dong-higenis/stm32h5-kit/hardware/stm32h5_kit.pdf

# 26.01.08 PHY (U16) 전원 수정

UART4 | (J21) 장치 선택 헤더 | 일체화 수정

## DCAB

6

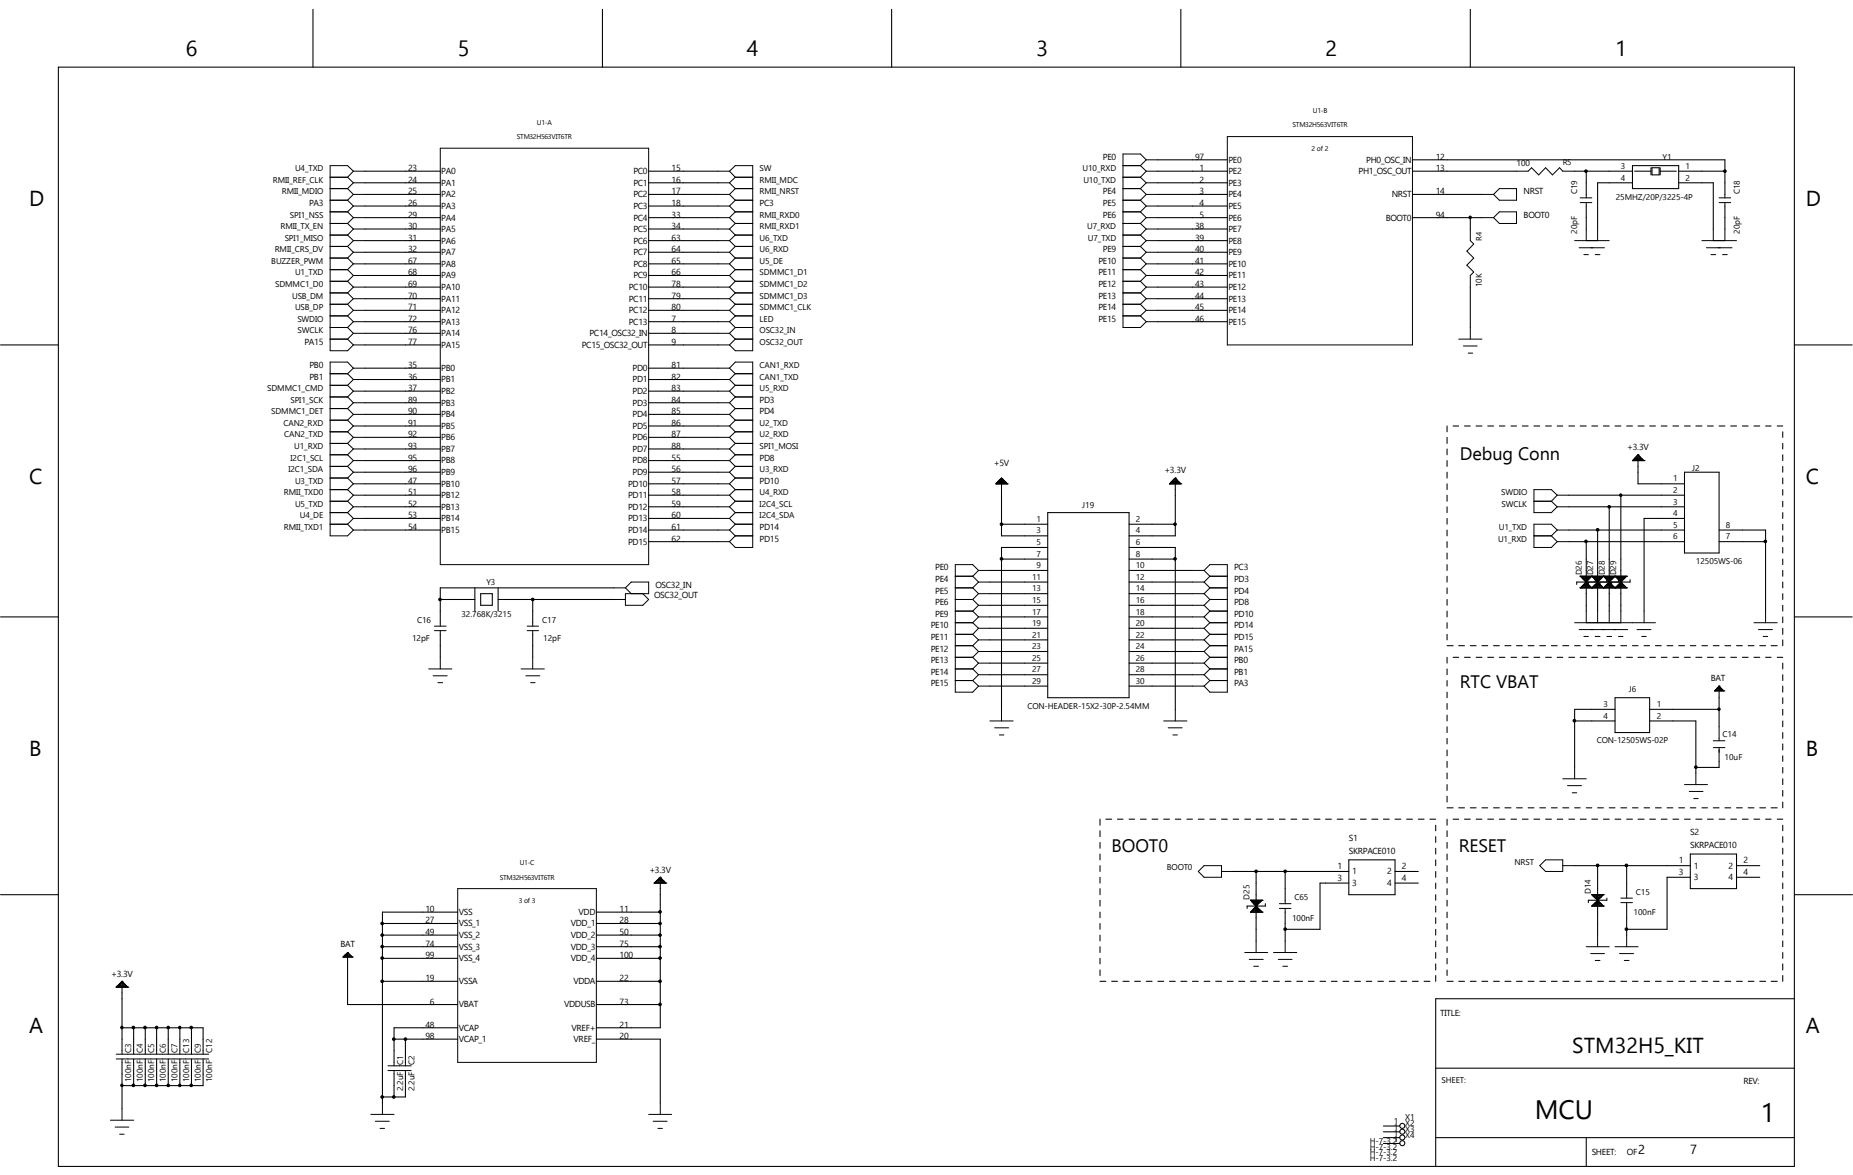
[picture p1: page 2]

12505WS-06 D²⁶ D²⁷ D²⁸ D²⁹ 1

27 VSS_1 | 28 VDD_1
49 VSS_2 | 50 VDD_2
74 VSS_3 | 75 VDD_3
99 VSS_4 | 100 VDD_4

D

6 | 5 | 4 | 3 | 2 | 1

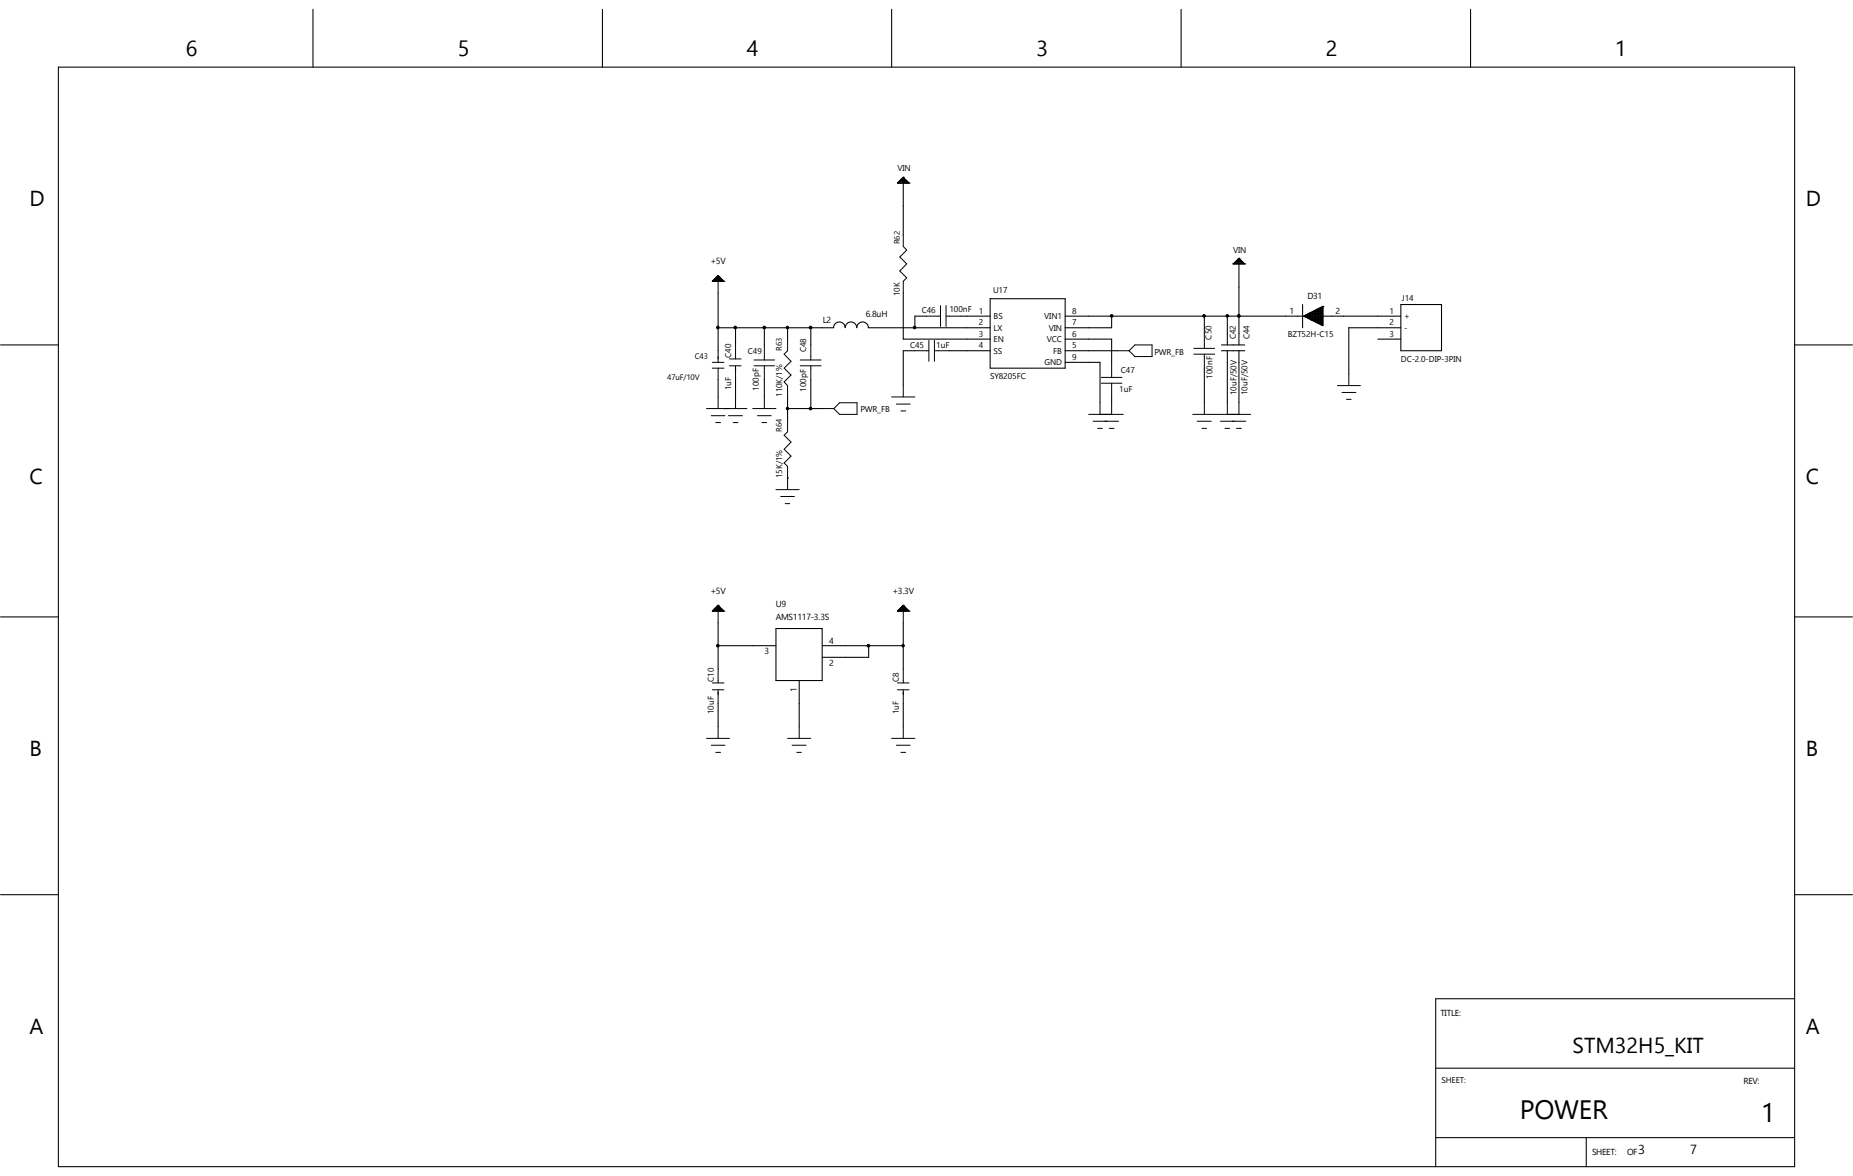
[picture p2: page 3]

D

6 | 5 | 4 | 3 | 2 | 1

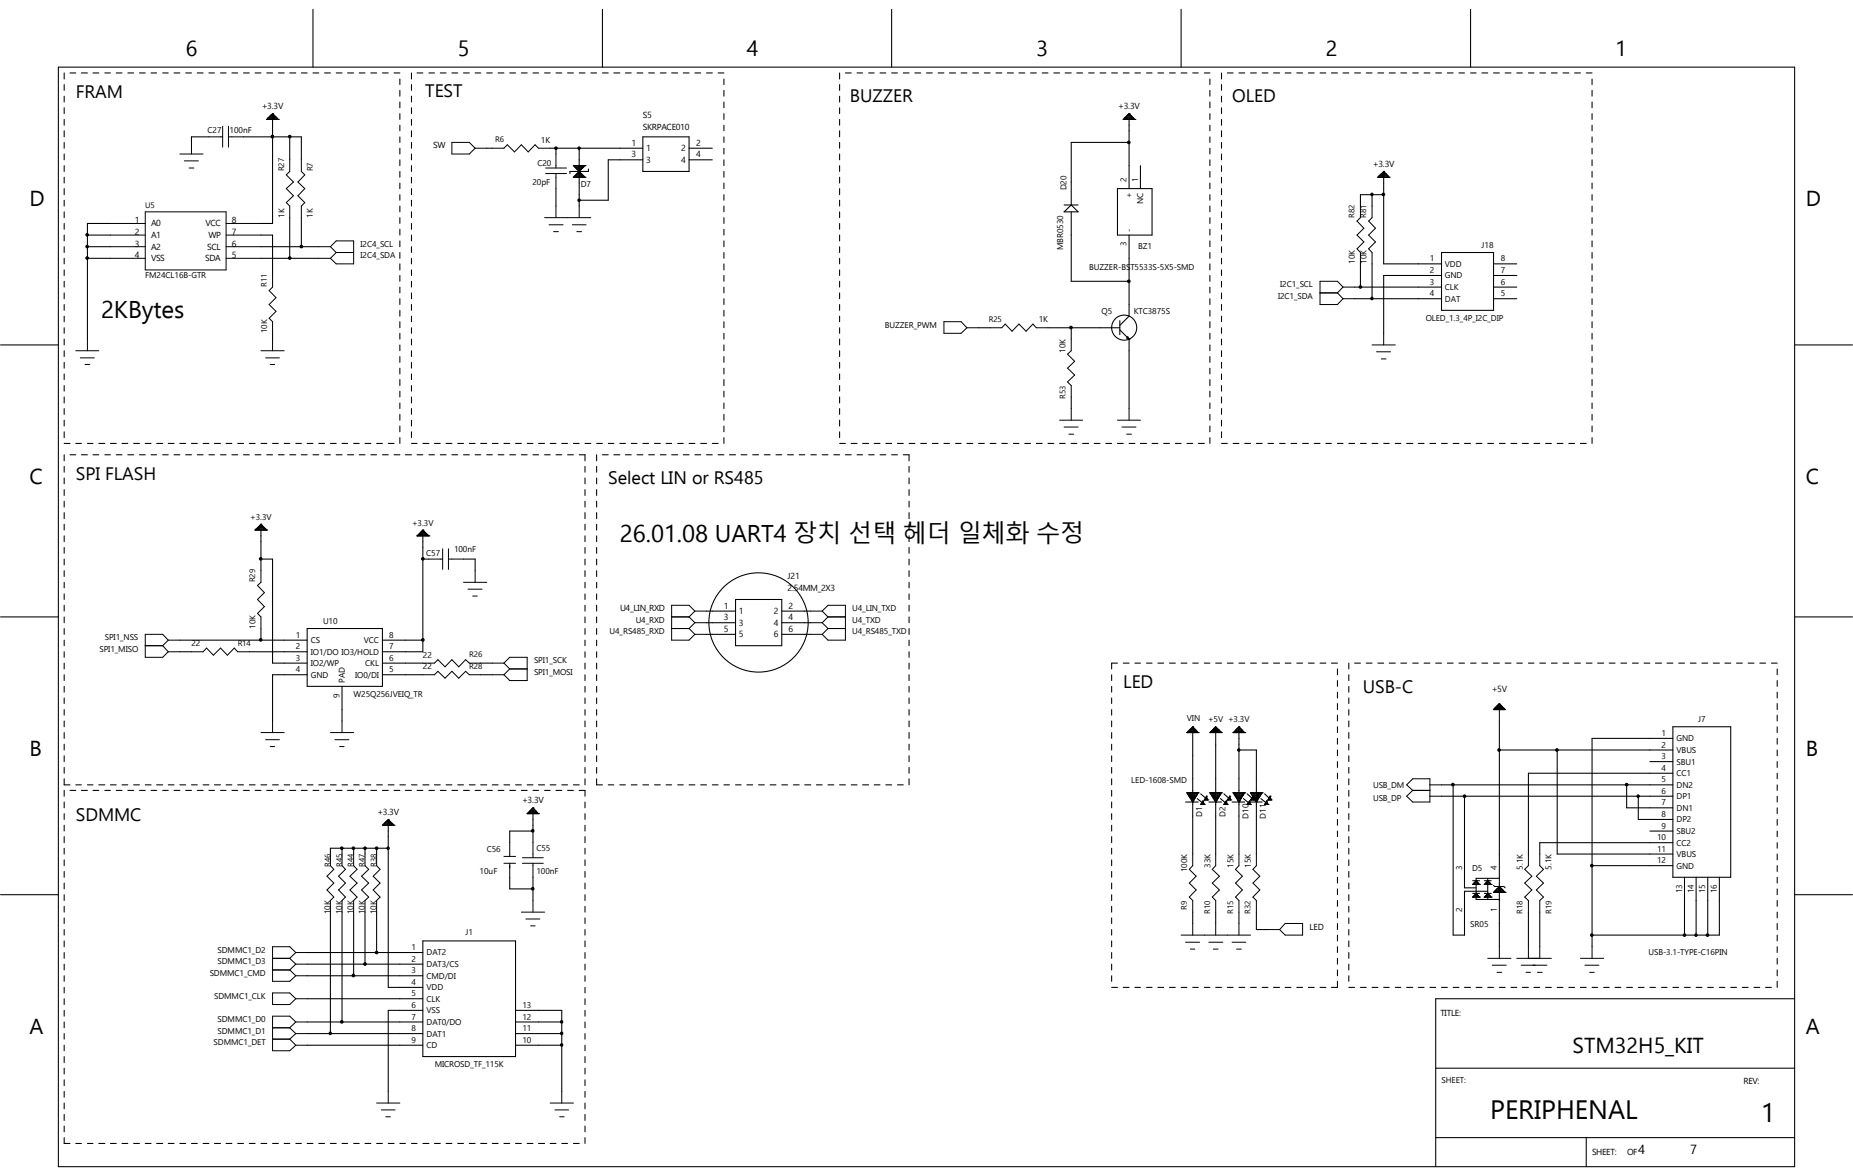
[picture p3: page 4]

Select LIN or RS485
26.01.08 UART4 장치 선택 헤더 일체화 수정

D

6 | 5 | 4 | 3 | 2 | 1

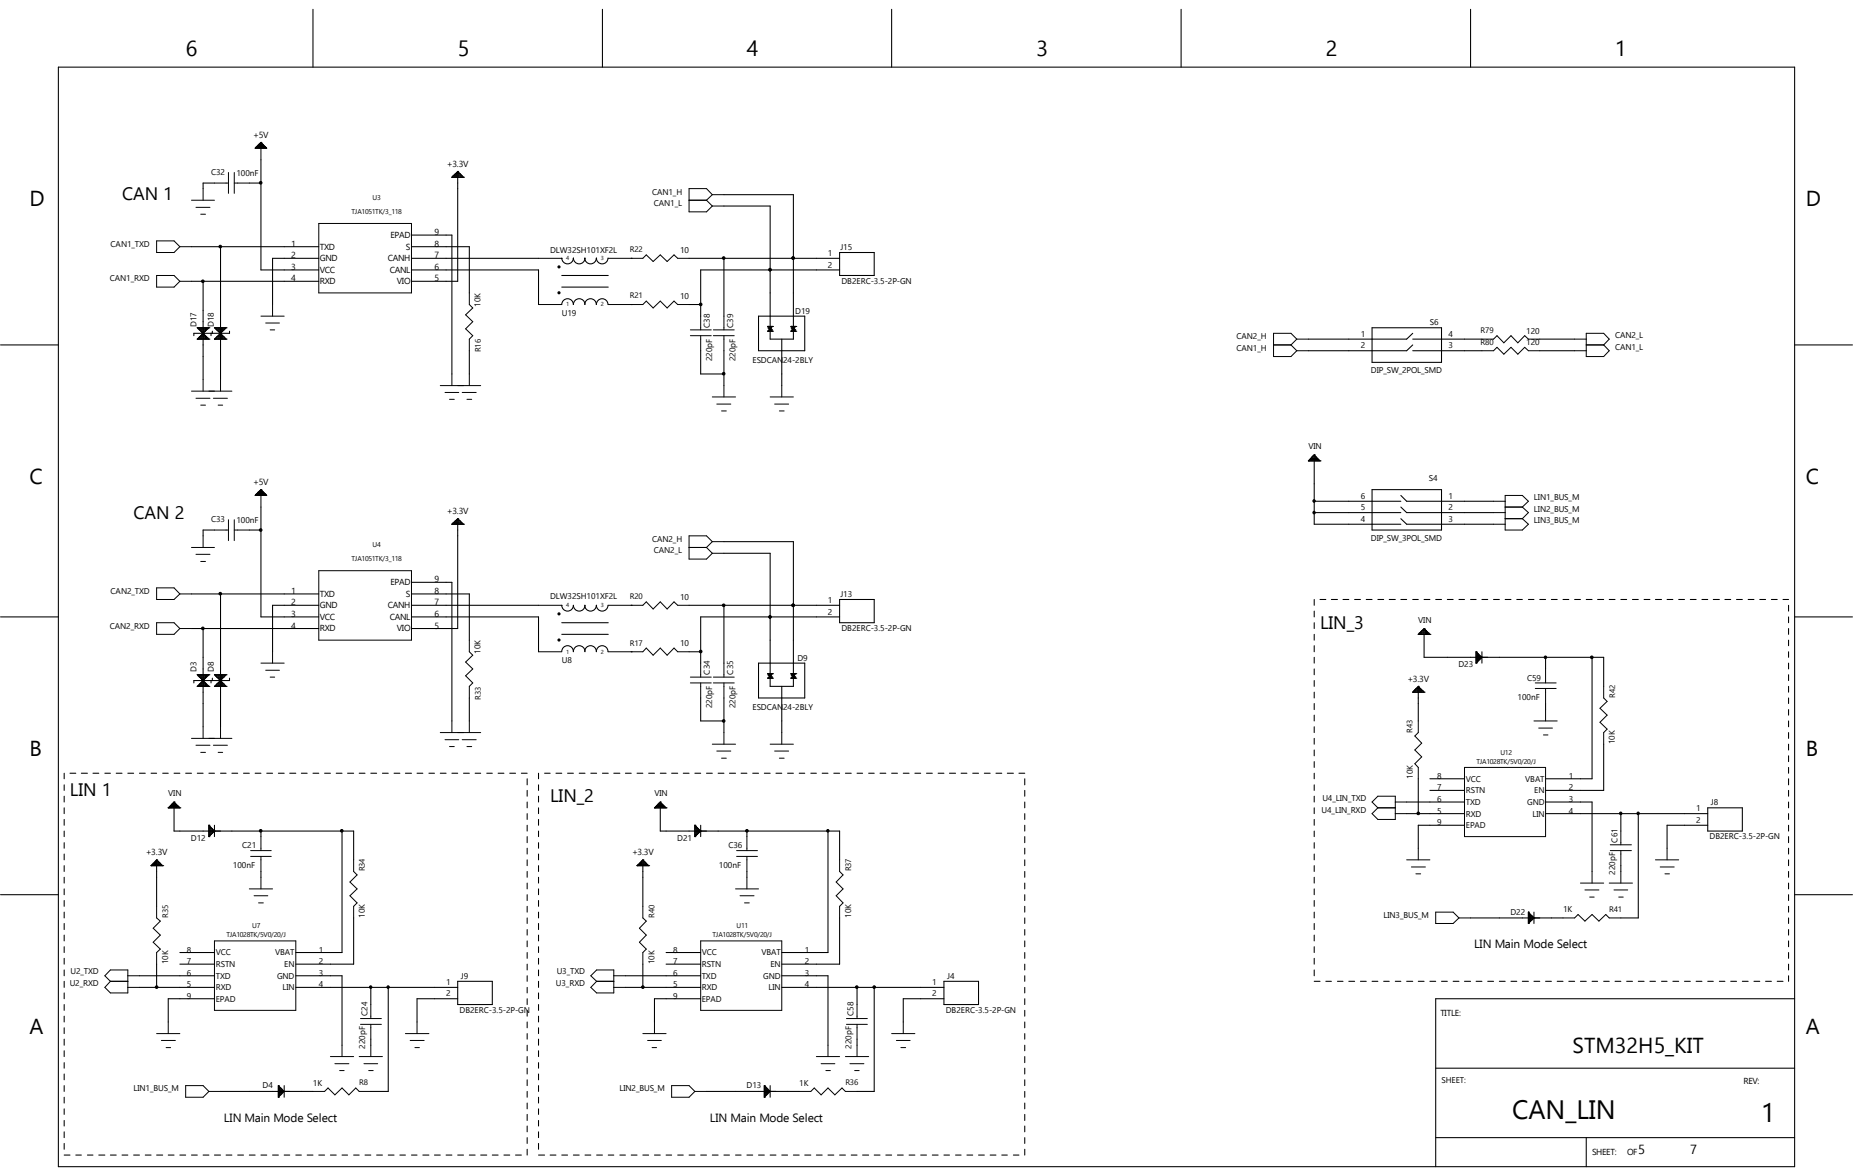
[picture p4: page 5]

7 CANH 6 CANL

LIN Main Mode Select

D

6 | 5 | 4 | 3 | 2 | 1

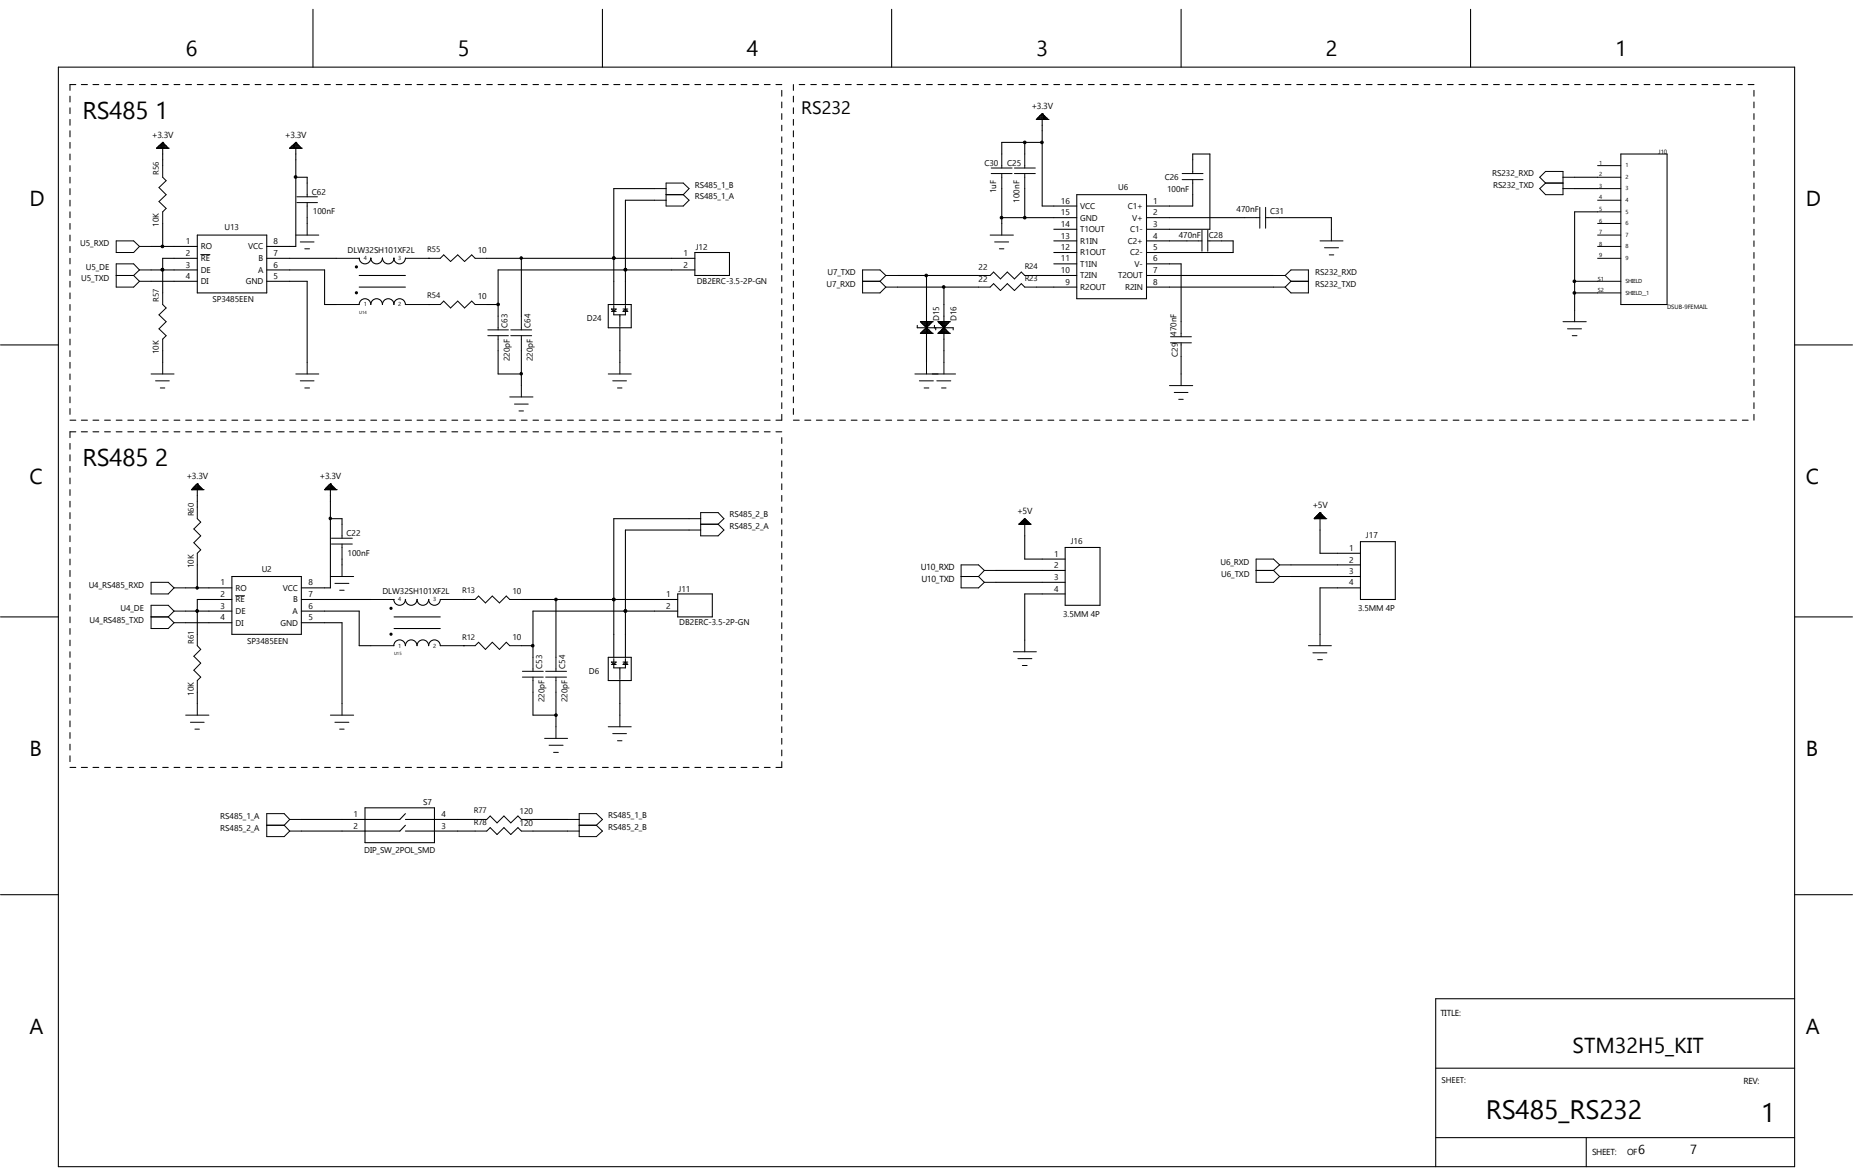
[picture p5: page 6]

5 GND

D

6 | 5 | 4 | 3 | 2 | 1

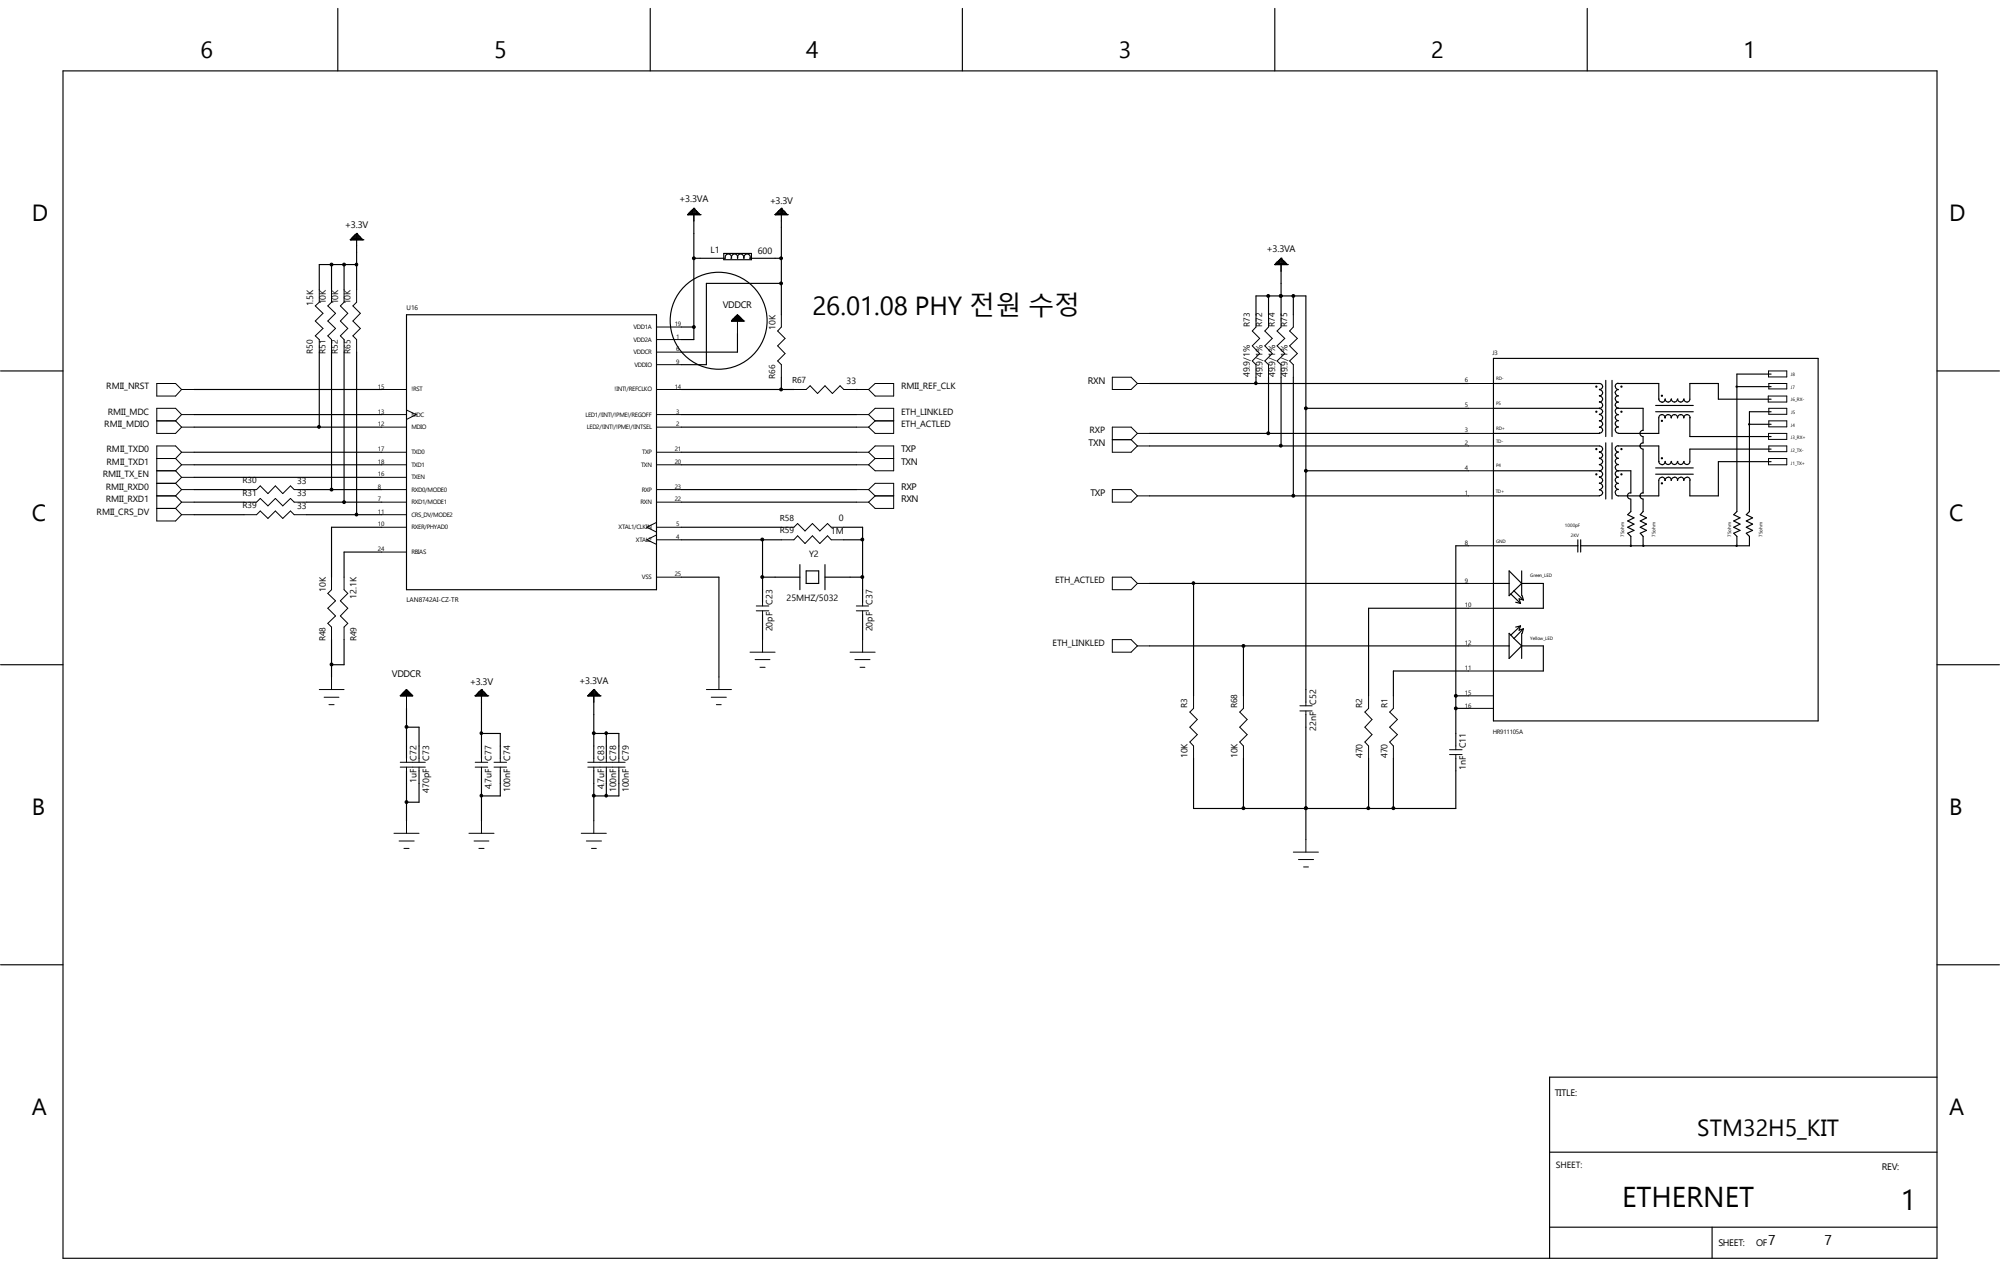
[picture p6: page 7]
