dong-higenis/stm32h5-kit/firmware/H5_SENSOR_READER/H5_SENSOR_READER.ioc

Mcu.UserName=STM32H563VITx
PA0.Signal=UART4_TX
PA9.Signal=USART1_TX
PB13.Signal=UART5_TX
PB14.GPIO_Label=U4_DE
PB14.Signal=GPIO_Output
PB7.Signal=USART1_RX
PB8.Signal=I2C1_SCL
PB9.Signal=I2C1_SDA
PC13.GPIO_Label=LED
PC13.Signal=GPIO_Output
PC14-OSC32_IN(OSC32_IN).Signal=RCC_OSC32_IN
PC15-OSC32_OUT(OSC32_OUT).Signal=RCC_OSC32_OUT
PC6.Signal=USART6_TX
PC7.Signal=USART6_RX
PC8.GPIO_Label=U5_DE
PC8.Signal=GPIO_Output
PD11.Signal=UART4_RX
PD2.Signal=UART5_RX
PE10.Signal=UART7_CTS
PE2.Signal=USART10_RX
PE3.Signal=USART10_TX
PE7.Signal=UART7_RX
PE8.Signal=UART7_TX
PE9.Signal=UART7_RTS
PH0-OSC_IN(PH0).Signal=RCC_OSC_IN
PH1-OSC_OUT(PH1).Signal=RCC_OSC_OUT
