dong-higenis/stm32h5-kit/firmware/H5_SENSOR_READER/Core/Inc/main.h

#define LED_Pin GPIO_PIN_13
#define LED_GPIO_Port GPIOC
#define U4_DE_Pin GPIO_PIN_14
#define U4_DE_GPIO_Port GPIOB
#define U5_DE_Pin GPIO_PIN_8
#define U5_DE_GPIO_Port GPIOC
