dong-higenis/stm32h5-kit/firmware/H5_CAN_LOGGER/src/hw/driver/i2c.c

#include "i2c.h"





#ifdef _USE_HW_I2C
#include "cli.h"

#ifdef _USE_HW_RTOS
#define lock(x)      xSemaphoreTake(mutex_lock[x], portMAX_DELAY);
#define unLock(x)    xSemaphoreGive(mutex_lock[x]);
static SemaphoreHandle_t mutex_lock[I2C_MAX_CH];
#else
#define lock(x)      
#define unLock(x)    
#endif

static uint32_t i2cGetTimming(uint32_t freq_khz);
static void delayUs(uint32_t us);
#ifdef _USE_HW_CLI
static void cliI2C(cli_args_t *args);
#endif



static uint32_t i2c_timeout[I2C_MAX_CH];
static uint32_t i2c_errcount[I2C_MAX_CH];
static uint32_t i2c_freq[I2C_MAX_CH];

static bool is_init = false;
static bool is_begin[I2C_MAX_CH];


static I2C_HandleTypeDef hi2c1;

typedef struct
{
  I2C_TypeDef       *p_i2c;
  I2C_HandleTypeDef *p_hi2c;

  GPIO_TypeDef *scl_port;
  int           scl_pin;

  GPIO_TypeDef *sda_port;
  int           sda_pin;

  const char   *p_name;
} i2c_tbl_t;

static i2c_tbl_t i2c_tbl[I2C_MAX_CH] = {
  {I2C1, &hi2c1, GPIOB, GPIO_PIN_8,  GPIOB, GPIO_PIN_9,  "I2C1 OLED"},  
};


bool i2cInit(void)
{
  uint32_t i;


  for (i=0; i<I2C_MAX_CH; i++)
  {
#ifdef _USE_HW_RTOS
    mutex_lock[i] = xSemaphoreCreateMutex();
#endif    
    i2c_timeout[i] = 10;
    i2c_errcount[i] = 0;
    is_begin[i] = false;
  }

#ifdef _USE_HW_CLI
  cliAdd("i2c", cliI2C);
#endif

  is_init = true;
  return true;
}

bool i2cIsInit(void)
{
  return is_init;
}

bool i2cBegin(uint8_t ch, uint32_t freq_khz)
{
  bool ret = false;

  I2C_HandleTypeDef *p_handle = i2c_tbl[ch].p_hi2c;

  if (ch >= I2C_MAX_CH)
  {
    return false;
  }


  switch(ch)
  {
    default:
      i2c_freq[ch] = freq_khz;

      p_handle->Instance             = i2c_tbl[ch].p_i2c;
      p_handle->Init.Timing          = i2cGetTimming(freq_khz);
      p_handle->Init.OwnAddress1     = 0x00;
      p_handle->Init.AddressingMode  = I2C_ADDRESSINGMODE_7BIT;
      p_handle->Init.DualAddressMode = I2C_DUALADDRESS_DISABLE;
      p_handle->Init.OwnAddress2     = 0x00;
      p_handle->Init.GeneralCallMode = I2C_GENERALCALL_DISABLE;
      p_handle->Init.NoStretchMode   = I2C_NOSTRETCH_DISABLE;

      i2cReset(ch);

      HAL_I2C_DeInit(p_handle);
      if(HAL_I2C_Init(p_handle) == HAL_OK)
      {
        ret = true;
      }

      /* Enable the Analog I2C Filter */
      HAL_I2CEx_ConfigAnalogFilter(p_handle,I2C_ANALOGFILTER_ENABLE);

      /* Configure Digital filter */
      HAL_I2CEx_ConfigDigitalFilter(p_handle, 0);

      is_begin[ch] = ret;
      break;
  }

  return ret;
}

uint32_t i2cGetTimming(uint32_t freq_khz)
{
  uint32_t ret;

  switch(freq_khz)
  {
    case 100:
      ret = 0x60808CD3;
      break;

    case 400:
      ret = 0x10C043E5;
      break;

    default:
      ret = 0x10C043E5;
      break;
  };

  return ret;
}

bool i2cIsBegin(uint8_t ch)
{
  return is_begin[ch];
}

void i2cReset(uint8_t ch)
{
  GPIO_InitTypeDef  GPIO_InitStruct;
  i2c_tbl_t *p_pin = &i2c_tbl[ch];

  lock(ch);
  GPIO_InitStruct.Pin       = p_pin->scl_pin;
  GPIO_InitStruct.Mode      = GPIO_MODE_OUTPUT_OD;
  GPIO_InitStruct.Pull      = GPIO_NOPULL;
  GPIO_InitStruct.Speed     = GPIO_SPEED_FREQ_HIGH;
  HAL_GPIO_Init(p_pin->scl_port, &GPIO_InitStruct);

  GPIO_InitStruct.Pin       = p_pin->sda_pin;
  GPIO_InitStruct.Mode      = GPIO_MODE_OUTPUT_OD;
  GPIO_InitStruct.Pull      = GPIO_NOPULL;
  HAL_GPIO_Init(p_pin->sda_port, &GPIO_InitStruct);


  HAL_GPIO_WritePin(p_pin->scl_port, p_pin->scl_pin, GPIO_PIN_SET);
  HAL_GPIO_WritePin(p_pin->sda_port, p_pin->sda_pin, GPIO_PIN_SET);
  delayUs(5);

  for (int i = 0; i < 9; i++)
  {

    HAL_GPIO_WritePin(p_pin->scl_port, p_pin->scl_pin, GPIO_PIN_RESET);
    delayUs(5);
    HAL_GPIO_WritePin(p_pin->scl_port, p_pin->scl_pin, GPIO_PIN_SET);
    delayUs(5);
  }

  HAL_GPIO_WritePin(p_pin->scl_port, p_pin->scl_pin, GPIO_PIN_RESET);
  delayUs(5);
  HAL_GPIO_WritePin(p_pin->sda_port, p_pin->sda_pin, GPIO_PIN_RESET);
  delayUs(5);

  HAL_GPIO_WritePin(p_pin->scl_port, p_pin->scl_pin, GPIO_PIN_SET);
  delayUs(5);
  HAL_GPIO_WritePin(p_pin->sda_port, p_pin->sda_pin, GPIO_PIN_SET);
  unLock(ch);
}

bool i2cIsDeviceReady(uint8_t ch, uint8_t dev_addr)
{
  bool ret = false;
  I2C_HandleTypeDef *p_handle = i2c_tbl[ch].p_hi2c;
  assert(is_begin[ch]);

  lock(ch);
  if (HAL_I2C_IsDeviceReady(p_handle, dev_addr << 1, 10, 10) == HAL_OK)
  {
    __enable_irq();
    ret = true;
  }
  unLock(ch);

  return ret;
}

bool i2cRecovery(uint8_t ch)
{
  bool ret;

  i2cReset(ch);

  ret = i2cBegin(ch, i2c_freq[ch]);

  return ret;
}

bool i2cReadByte (uint8_t ch, uint16_t dev_addr, uint16_t reg_addr, uint8_t *p_data, uint32_t timeout)
{
  return i2cReadBytes(ch, dev_addr, reg_addr, p_data, 1, timeout);
}

bool i2cReadBytes(uint8_t ch, uint16_t dev_addr, uint16_t reg_addr, uint8_t *p_data, uint32_t length, uint32_t timeout)
{
  bool ret;
  HAL_StatusTypeDef i2c_ret;
  I2C_HandleTypeDef *p_handle = i2c_tbl[ch].p_hi2c;

  if (ch >= I2C_MAX_CH)
  {
    return false;
  }

  lock(ch);
  i2c_ret = HAL_I2C_Mem_Read(p_handle, (uint16_t)(dev_addr << 1), reg_addr, I2C_MEMADD_SIZE_8BIT, p_data, length, timeout);
  unLock(ch);

  if( i2c_ret == HAL_OK )
  {
    ret = true;
  }
  else
  {
    ret = false;
  }

  return ret;
}

bool i2cReadA16Bytes(uint8_t ch, uint16_t dev_addr, uint16_t reg_addr, uint8_t *p_data, uint32_t length, uint32_t timeout)
{
  bool ret;
  HAL_StatusTypeDef i2c_ret;
  I2C_HandleTypeDef *p_handle = i2c_tbl[ch].p_hi2c;

  if (ch >= I2C_MAX_CH)
  {
    return false;
  }

  lock(ch);
  i2c_ret = HAL_I2C_Mem_Read(p_handle, (uint16_t)(dev_addr << 1), reg_addr, I2C_MEMADD_SIZE_16BIT, p_data, length, timeout);
  unLock(ch);

  if( i2c_ret == HAL_OK )
  {
    ret = true;
  }
  else
  {
    ret = false;
  }

  return ret;
}

bool i2cReadData(uint8_t ch, uint16_t dev_addr, uint8_t *p_data, uint32_t length, uint32_t timeout)
{
  bool ret;
  HAL_StatusTypeDef i2c_ret;
  I2C_HandleTypeDef *p_handle = i2c_tbl[ch].p_hi2c;

  if (ch >= I2C_MAX_CH)
  {
    return false;
  }

  lock(ch);
  i2c_ret = HAL_I2C_Master_Receive(p_handle, (uint16_t)(dev_addr << 1), p_data, length, timeout);
  unLock(ch);

  if( i2c_ret == HAL_OK )
  {
    ret = true;
  }
  else
  {
    ret = false;
  }

  return ret;
}

bool i2cWriteByte (uint8_t ch, uint16_t dev_addr, uint16_t reg_addr, uint8_t data, uint32_t timeout)
{
  return i2cWriteBytes(ch, dev_addr, reg_addr, &data, 1, timeout);
}

bool i2cWriteBytes(uint8_t ch, uint16_t dev_addr, uint16_t reg_addr, uint8_t *p_data, uint32_t length, uint32_t timeout)
{
  bool ret;
  HAL_StatusTypeDef i2c_ret;
  I2C_HandleTypeDef *p_handle = i2c_tbl[ch].p_hi2c;

  if (ch >= I2C_MAX_CH)
  {
    return false;
  }

  lock(ch);
  i2c_ret = HAL_I2C_Mem_Write(p_handle, (uint16_t)(dev_addr << 1), reg_addr, I2C_MEMADD_SIZE_8BIT, p_data, length, timeout);
  unLock(ch);

  if(i2c_ret == HAL_OK)
  {
    ret = true;
  }
  else
  {
    ret = false;
  }

  return ret;
}

bool i2cWriteA16Bytes(uint8_t ch, uint16_t dev_addr, uint16_t reg_addr, uint8_t *p_data, uint32_t length, uint32_t timeout)
{
  bool ret;
  HAL_StatusTypeDef i2c_ret;
  I2C_HandleTypeDef *p_handle = i2c_tbl[ch].p_hi2c;

  if (ch >= I2C_MAX_CH)
  {
    return false;
  }

  lock(ch);
  i2c_ret = HAL_I2C_Mem_Write(p_handle, (uint16_t)(dev_addr << 1), reg_addr, I2C_MEMADD_SIZE_16BIT, p_data, length, timeout);
  unLock(ch);

  if(i2c_ret == HAL_OK)
  {
    ret = true;
  }
  else
  {
    ret = false;
  }

  return ret;
}

bool i2cWriteData(uint8_t ch, uint16_t dev_addr, uint8_t *p_data, uint32_t length, uint32_t timeout)
{
  bool ret;
  HAL_StatusTypeDef i2c_ret;
  I2C_HandleTypeDef *p_handle = i2c_tbl[ch].p_hi2c;

  if (ch >= I2C_MAX_CH)
  {
    return false;
  }

  lock(ch);
  i2c_ret = HAL_I2C_Master_Transmit(p_handle, (uint16_t)(dev_addr << 1), p_data, length, timeout);
  unLock(ch);
  
  if(i2c_ret == HAL_OK)
  {
    ret = true;
  }
  else
  {
    ret = false;
  }

  return ret;
}

void i2cSetTimeout(uint8_t ch, uint32_t timeout)
{
  i2c_timeout[ch] = timeout;
}

uint32_t i2cGetTimeout(uint8_t ch)
{
  return i2c_timeout[ch];
}

void i2cClearErrCount(uint8_t ch)
{
  i2c_errcount[ch] = 0;
}

uint32_t i2cGetErrCount(uint8_t ch)
{
  return i2c_errcount[ch];
}

void delayUs(uint32_t us)
{
  volatile uint32_t i;

  for (i=0; i<us*1000; i++)
  {

  }
}





void HAL_I2C_ErrorCallback(I2C_HandleTypeDef *hi2c)
{
  UNUSED(hi2c);

}


void HAL_I2C_MspInit(I2C_HandleTypeDef* i2cHandle)
{
  GPIO_InitTypeDef GPIO_InitStruct = {0};
  RCC_PeriphCLKInitTypeDef PeriphClkInitStruct = {0};
  if(i2cHandle->Instance==I2C1)
  {

  /** Initializes the peripherals clock
  */
    PeriphClkInitStruct.PeriphClockSelection = RCC_PERIPHCLK_I2C1;
    PeriphClkInitStruct.I2c1ClockSelection = RCC_I2C1CLKSOURCE_PCLK1;
    if (HAL_RCCEx_PeriphCLKConfig(&PeriphClkInitStruct) != HAL_OK)
    {
      Error_Handler();
    }

    __HAL_RCC_GPIOB_CLK_ENABLE();
    /**I2C1 GPIO Configuration
    PB7     ------> I2C1_SDA
    PB8     ------> I2C1_SCL
    */
    GPIO_InitStruct.Pin = GPIO_PIN_9|GPIO_PIN_8;
    GPIO_InitStruct.Mode = GPIO_MODE_AF_OD;
    GPIO_InitStruct.Pull = GPIO_NOPULL;
    GPIO_InitStruct.Speed = GPIO_SPEED_FREQ_LOW;
    GPIO_InitStruct.Alternate = GPIO_AF4_I2C1;
    HAL_GPIO_Init(GPIOB, &GPIO_InitStruct);

    /* I2C1 clock enable */
    __HAL_RCC_I2C1_CLK_ENABLE();
  }
}

void HAL_I2C_MspDeInit(I2C_HandleTypeDef* i2cHandle)
{
  if(i2cHandle->Instance==I2C1)
  {
    /* Peripheral clock disable */
    __HAL_RCC_I2C1_CLK_DISABLE();

    /**I2C1 GPIO Configuration
    PB7     ------> I2C1_SDA
    PB8     ------> I2C1_SCL
    */
    HAL_GPIO_DeInit(GPIOB, GPIO_PIN_9);

    HAL_GPIO_DeInit(GPIOB, GPIO_PIN_8);
  }  
}


#ifdef _USE_HW_CLI
void cliI2C(cli_args_t *args)
{
  bool ret = false;
  bool i2c_ret;

  uint8_t print_ch;
  uint8_t ch;
  uint16_t dev_addr;
  uint16_t reg_addr;
  uint16_t length;
  uint32_t pre_time;

  if (args->argc == 1 && args->isStr(0, "info") == true)
  {
    for (int i=0; i<I2C_MAX_CH; i++)
    {
      cliPrintf("%02d. %-16s %03d Khz\n", 
        i+1,
        i2c_tbl[i].p_name,
        i2c_freq[i]
      );
    }
    ret = true;
  }

  if (args->argc == 2 && args->isStr(0, "scan") == true)
  {
    uint32_t dev_cnt = 0;
    print_ch = (uint16_t) args->getData(1);

    print_ch = constrain(print_ch, 1, I2C_MAX_CH);
    print_ch -= 1;

    for (int i=0x00; i<= 0x7F; i++)
    {
      if (i2cIsDeviceReady(print_ch, i) == true)
      {
        cliPrintf("I2C CH%d Addr 0x%02X : OK\n", print_ch+1, i);
        dev_cnt++;
      }
    }
    if (dev_cnt == 0)
    {
      cliPrintf("no found\n");
    }
    ret = true;  
  }

  if (args->argc == 2 && args->isStr(0, "begin") == true)
  {
    print_ch = (uint16_t) args->getData(1);

    print_ch = constrain(print_ch, 1, I2C_MAX_CH);
    print_ch -= 1;

    i2c_ret = i2cBegin(print_ch, 400);
    if (i2c_ret == true)
    {
      cliPrintf("I2C CH%d Begin OK\n", print_ch + 1);
    }
    else
    {
      cliPrintf("I2C CH%d Begin Fail\n", print_ch + 1);
    }
    ret = true;
  }

  if (args->argc == 5 && args->isStr(0, "read") == true)
  {
    print_ch = (uint16_t) args->getData(1);
    print_ch = constrain(print_ch, 1, I2C_MAX_CH);

    dev_addr = (uint16_t) args->getData(2);
    reg_addr = (uint16_t) args->getData(3);
    length   = (uint16_t) args->getData(4);
    ch       = print_ch - 1;

    for (int i=0; i<length; i++)
    {
      uint8_t i2c_data;
      i2c_ret = i2cReadByte(ch, dev_addr, reg_addr+i, &i2c_data, 100);

      if (i2c_ret == true)
      {
        cliPrintf("%d I2C - 0x%02X : 0x%02X\n", print_ch, reg_addr+i, i2c_data);
      }
      else
      {
        cliPrintf("%d I2C - Fail \n", print_ch);
        break;
      }
    }
    ret = true;
  }

  if (args->argc == 5 && args->isStr(0, "write") == true)
  {
    print_ch = (uint16_t) args->getData(1);
    print_ch = constrain(print_ch, 1, I2C_MAX_CH);

    dev_addr = (uint16_t) args->getData(2);
    reg_addr = (uint16_t) args->getData(3);
    length   = (uint16_t) args->getData(4);
    ch       = print_ch - 1;

    pre_time = millis();
    i2c_ret = i2cWriteByte(ch, dev_addr, reg_addr, (uint8_t)length, 100);

    if (i2c_ret == true)
    {
      cliPrintf("%d I2C - 0x%02X : 0x%02X, %d ms\n", print_ch, reg_addr, length, millis()-pre_time);
    }
    else
    {
      cliPrintf("%d I2C - Fail \n", print_ch);
    }
    ret = true;
  }


  if (ret == false)
  {
    cliPrintf("i2c info\n");
    cliPrintf("i2c begin ch[1~%d]\n", I2C_MAX_CH);
    cliPrintf("i2c scan  ch[1~%d]\n", I2C_MAX_CH);
    cliPrintf("i2c read  ch dev_addr reg_addr length\n");
    cliPrintf("i2c write ch dev_addr reg_addr data\n");
  }
}

#endif

#endif
