dong-higenis/stm32h5-kit/firmware/H5_CAN_LOGGER/src/hw/hw.c

#include "hw.h"


extern uint32_t _fw_flash_begin;
  extern UART_HandleTypeDef huart1;
volatile const firm_ver_t firm_ver __attribute__((section(".version"))) =
{
  .magic_number = VERSION_MAGIC_NUMBER,
  .version_str  = _DEF_FIRMWATRE_VERSION,
  .name_str     = _DEF_BOARD_NAME,
  .firm_addr    = (uint32_t)&_fw_flash_begin};

bool hwInit(void)
{
  cliInit();
  logInit();
  swtimerInit();
  microsInit();
  ledInit();
  uartInit();

  uartOpen(HW_UART_CH_DEBUG, 115200);

  logOpen(HW_LOG_CH, 115200);
  logPrintf("\r\n[ Firmware Begin... ]\r\n");
  logPrintf("Booting..Name \t\t: %s\r\n", _DEF_BOARD_NAME);
  logPrintf("Booting..Ver  \t\t: %s\r\n", _DEF_FIRMWATRE_VERSION);
  logPrintf("Booting..Clock\t\t: %d Mhz\r\n", (int)HAL_RCC_GetSysClockFreq() / 1000000);
  logPrintf("Booting..Date \t\t: %s\r\n", __DATE__);
  logPrintf("Booting..Time \t\t: %s\r\n", __TIME__);
  logPrintf("Booting..Addr \t\t: 0x%X\r\n", (uint32_t)&_fw_flash_begin);

  logPrintf("\n");

  rtcInit();
  resetInit();
  faultInit();
  assertInit();

  gpioInit();
  i2cInit();
  spiInit();
  buttonInit();
  buzzerInit();
  pwmInit();
  spiFlashInit();
  fsInit();
  nvsInit();
  lcdInit();
  canInit();
  sdInit();
  fatfsInit();
  etnetInit();
  threadInit();

  return true;
}
