dong-higenis/stm32h5-kit/firmware/H5_CAN_LOGGER/src/hw/driver/gpio.c

#include "gpio.h"


#ifdef _USE_HW_GPIO
#include "cli.h"


#define NAME_DEF(x) x, #x

typedef struct
{
  GPIO_TypeDef *port;
  uint32_t      pin;
  uint8_t       mode;
  GPIO_PinState on_state;
  GPIO_PinState off_state;
  bool          init_value;
  GpioPinName_t pin_name;
  const char   *p_name;
} gpio_tbl_t;

const gpio_tbl_t gpio_tbl[GPIO_MAX_CH] =
{
  {GPIOA, GPIO_PIN_4, _DEF_OUTPUT,        GPIO_PIN_SET, GPIO_PIN_RESET, _DEF_HIGH, NAME_DEF(SPI_FLASH_CS)},
  {GPIOB, GPIO_PIN_4, _DEF_INPUT_IT_BOTH, GPIO_PIN_SET, GPIO_PIN_RESET, _DEF_HIGH, NAME_DEF(SD_DETECT)   },
};


#ifdef _USE_HW_CLI
static void cliGpio(cli_args_t *args);
#endif


bool gpioInit(void)
{
  bool ret = true;

  __HAL_RCC_GPIOA_CLK_ENABLE();
  __HAL_RCC_GPIOB_CLK_ENABLE();
  __HAL_RCC_GPIOE_CLK_ENABLE();


  for (int i = 0; i < GPIO_MAX_CH; i++)
  {
    gpioPinMode(i, gpio_tbl[i].mode);
    gpioPinWrite(i, gpio_tbl[i].init_value);
  }

#ifdef _USE_HW_CLI
  cliAdd("gpio", cliGpio);
#endif

  return ret;
}

bool gpioPinMode(uint8_t ch, uint8_t mode)
{
  bool             ret             = true;
  GPIO_InitTypeDef GPIO_InitStruct = {0};


  if (ch >= GPIO_MAX_CH)
  {
    return false;
  }

  switch (mode)
  {
    case _DEF_INPUT:
      GPIO_InitStruct.Mode = GPIO_MODE_INPUT;
      GPIO_InitStruct.Pull = GPIO_NOPULL;
      break;

    case _DEF_INPUT_PULLUP:
      GPIO_InitStruct.Mode = GPIO_MODE_INPUT;
      GPIO_InitStruct.Pull = GPIO_PULLUP;
      break;

    case _DEF_INPUT_PULLDOWN:
      GPIO_InitStruct.Mode = GPIO_MODE_INPUT;
      GPIO_InitStruct.Pull = GPIO_PULLDOWN;
      break;

    case _DEF_OUTPUT:
      GPIO_InitStruct.Mode = GPIO_MODE_OUTPUT_PP;
      GPIO_InitStruct.Pull = GPIO_NOPULL;
      break;

    case _DEF_OUTPUT_PULLUP:
      GPIO_InitStruct.Mode = GPIO_MODE_OUTPUT_PP;
      GPIO_InitStruct.Pull = GPIO_PULLUP;
      break;

    case _DEF_OUTPUT_PULLDOWN:
      GPIO_InitStruct.Mode = GPIO_MODE_OUTPUT_PP;
      GPIO_InitStruct.Pull = GPIO_PULLDOWN;
      break;

    case _DEF_INPUT_IT_BOTH:
      GPIO_InitStruct.Mode = GPIO_MODE_IT_RISING_FALLING;
      GPIO_InitStruct.Pull = GPIO_PULLUP;
      break;
  }

  GPIO_InitStruct.Pin = gpio_tbl[ch].pin;
  HAL_GPIO_Init(gpio_tbl[ch].port, &GPIO_InitStruct);

  return ret;
}

void gpioPinWrite(uint8_t ch, bool value)
{
  if (ch >= GPIO_MAX_CH)
  {
    return;
  }

  if (value)
  {
    HAL_GPIO_WritePin(gpio_tbl[ch].port, gpio_tbl[ch].pin, gpio_tbl[ch].on_state);
  }
  else
  {
    HAL_GPIO_WritePin(gpio_tbl[ch].port, gpio_tbl[ch].pin, gpio_tbl[ch].off_state);
  }
}

bool gpioPinRead(uint8_t ch)
{
  bool ret = false;

  if (ch >= GPIO_MAX_CH)
  {
    return false;
  }

  if (HAL_GPIO_ReadPin(gpio_tbl[ch].port, gpio_tbl[ch].pin) == gpio_tbl[ch].on_state)
  {
    ret = true;
  }

  return ret;
}

void gpioPinToggle(uint8_t ch)
{
  if (ch >= GPIO_MAX_CH)
  {
    return;
  }

  HAL_GPIO_TogglePin(gpio_tbl[ch].port, gpio_tbl[ch].pin);
}


#ifdef _USE_HW_CLI
void cliGpio(cli_args_t *args)
{
  bool ret = false;


  if (args->argc == 1 && args->isStr(0, "info") == true)
  {
    for (int i = 0; i < GPIO_MAX_CH; i++)
    {
      cliPrintf("%d %-16s - %d\n", i, gpio_tbl[i].p_name, gpioPinRead(i));
    }
    ret = true;
  }

  if (args->argc == 1 && args->isStr(0, "show") == true)
  {
    while (cliKeepLoop())
    {
      for (int i = 0; i < GPIO_MAX_CH; i++)
      {
        cliPrintf("%02d %-16s - %d\n", i, gpio_tbl[i].p_name, gpioPinRead(i));
      }
      delay(100);
      cliMoveUp(GPIO_MAX_CH);
    }
    cliMoveDown(GPIO_MAX_CH);
    ret = true;
  }

  if (args->argc == 2 && args->isStr(0, "read") == true)
  {
    uint8_t ch;

    ch = (uint8_t)args->getData(1);

    while (cliKeepLoop())
    {
      cliPrintf("gpio read %d : %d\n", ch, gpioPinRead(ch));
      delay(100);
    }

    ret = true;
  }

  if (args->argc == 3 && args->isStr(0, "write") == true)
  {
    uint8_t ch;
    uint8_t data;

    ch   = (uint8_t)args->getData(1);
    data = (uint8_t)args->getData(2);

    gpioPinWrite(ch, data);

    cliPrintf("gpio write %d : %d\n", ch, data);
    ret = true;
  }

  if (ret != true)
  {
    cliPrintf("gpio info\n");
    cliPrintf("gpio show\n");
    cliPrintf("gpio read ch[0~%d]\n", GPIO_MAX_CH - 1);
    cliPrintf("gpio write ch[0~%d] 0:1\n", GPIO_MAX_CH - 1);
  }
}
#endif


#endif
