dong-higenis/stm32h5-kit/firmware/H5_CAN_LOGGER/src/hw/driver/buzzer.c

#include "buzzer.h"


#ifdef _USE_HW_BUZZER
#include "cli.h"
#include "swtimer.h"


static bool is_init = false;
static bool is_on = false;
static uint16_t on_time_cnt = 0;
static TIM_HandleTypeDef htim2;


#ifdef _USE_HW_CLI
static void cliBuzzer(cli_args_t *args);
#endif
static bool buzzerInitTimer(void);


void buzzerISR(void *arg)
{
  if (is_on && on_time_cnt > 0)
  {
    on_time_cnt--;

    if (on_time_cnt == 0)
    {
      buzzerOff();
    }
  }
}




bool buzzerInit(void)
{
  bool ret = true;


  ret = buzzerInitTimer();
  assert(ret);

  swtimer_handle_t timer_ch;
  timer_ch = swtimerGetHandle();
  swtimerSet(timer_ch, 1, LOOP_TIME, buzzerISR, NULL);
  swtimerStart(timer_ch);

  
#ifdef _USE_HW_CLI
  cliAdd("buzzer", cliBuzzer);
#endif  

  logPrintf("[%s] buzzerInit()\n", ret ? "OK":"NG");

  is_init = ret;
  return ret;
}

bool buzzerInitTimer(void)
{
  bool ret = true;
  TIM_ClockConfigTypeDef sClockSourceConfig = {0};
  TIM_MasterConfigTypeDef sMasterConfig = {0};
  TIM_OC_InitTypeDef sConfigOC = {0};
  // TIM_BreakDeadTimeConfigTypeDef sBreakDeadTimeConfig = {0};
  GPIO_InitTypeDef GPIO_InitStruct = {0};


  __HAL_RCC_TIM2_CLK_ENABLE();

  htim2.Instance = TIM2;
  htim2.Init.Prescaler = 249;
  htim2.Init.CounterMode = TIM_COUNTERMODE_UP;
  htim2.Init.Period = 1000;
  htim2.Init.ClockDivision = TIM_CLOCKDIVISION_DIV1;
  htim2.Init.RepetitionCounter = 0;
  htim2.Init.AutoReloadPreload = TIM_AUTORELOAD_PRELOAD_ENABLE;
  if (HAL_TIM_Base_Init(&htim2) != HAL_OK)
  {
    ret = false;
  }
  sClockSourceConfig.ClockSource = TIM_CLOCKSOURCE_INTERNAL;
  if (HAL_TIM_ConfigClockSource(&htim2, &sClockSourceConfig) != HAL_OK)
  {
    ret = false;
  }
  if (HAL_TIM_OC_Init(&htim2) != HAL_OK)
  {
    ret = false;
  }
  sMasterConfig.MasterOutputTrigger = TIM_TRGO_RESET;
  sMasterConfig.MasterSlaveMode = TIM_MASTERSLAVEMODE_DISABLE;
  if (HAL_TIMEx_MasterConfigSynchronization(&htim2, &sMasterConfig) != HAL_OK)
  {
    ret = false;
  }
  sConfigOC.OCMode = TIM_OCMODE_TOGGLE;
  sConfigOC.Pulse = 0;
  sConfigOC.OCPolarity = TIM_OCPOLARITY_HIGH;
  sConfigOC.OCNPolarity = TIM_OCNPOLARITY_HIGH;
  sConfigOC.OCFastMode = TIM_OCFAST_DISABLE;
  sConfigOC.OCIdleState = TIM_OCIDLESTATE_RESET;
  sConfigOC.OCNIdleState = TIM_OCNIDLESTATE_RESET;
  if (HAL_TIM_OC_ConfigChannel(&htim2, &sConfigOC, TIM_CHANNEL_1) != HAL_OK)
  {
    ret = false;
  }
  __HAL_TIM_ENABLE_OCxPRELOAD(&htim2, TIM_CHANNEL_1);


  __HAL_RCC_GPIOA_CLK_ENABLE();
  /**TIM2 GPIO Configuration
  PA15(JTDI)     ------> TIM2_CH1
  */
  GPIO_InitStruct.Pin = GPIO_PIN_15;
  GPIO_InitStruct.Mode = GPIO_MODE_AF_PP;
  GPIO_InitStruct.Pull = GPIO_NOPULL;
  GPIO_InitStruct.Speed = GPIO_SPEED_FREQ_LOW;
  GPIO_InitStruct.Alternate = GPIO_AF1_TIM2;
  HAL_GPIO_Init(GPIOA, &GPIO_InitStruct);

  return ret;
}

void buzzerOn(uint16_t freq_hz, uint16_t time_ms)
{
  uint32_t freq_cmp;

  freq_cmp = (1000000/freq_hz) - 1;

  if (freq_hz >= 20 && freq_hz <= 500000)
  {
    htim2.Instance->ARR = freq_cmp/2;

    HAL_TIM_OC_Start(&htim2, TIM_CHANNEL_1);
  }
  is_on = true;
  on_time_cnt = time_ms;
}

void buzzerBeep(uint16_t time_ms)
{
  buzzerOn(1000, time_ms);
}

void buzzerOff(void)
{
  HAL_TIM_OC_Stop(&htim2, TIM_CHANNEL_1);

  is_on = false;
}

#ifdef _USE_HW_CLI
void cliBuzzer(cli_args_t *args)
{
  bool ret = false;


  if (args->argc == 3 && args->isStr(0, "on"))
  {
    uint16_t freq_hz;
    uint16_t time_ms;

    freq_hz = args->getData(1);
    time_ms = args->getData(2);

    buzzerOn(freq_hz, time_ms);
    ret = true;
  }
  
  if (args->argc == 1 && args->isStr(0, "off"))
  {
    buzzerOff();
    ret = true;
  }

  if (args->argc == 1 && args->isStr(0, "test"))
  {
    uint16_t freq_tbl[8] = {261, 293, 329, 349, 391, 440, 493, 523};
    uint8_t freq_i;

    for (int i=0; i<16; i++)
    {
      if (i/8 == 0)
      {
        freq_i = i%8;
      }
      else
      {
        freq_i = 7 - (i%8);
      }
      buzzerOn(freq_tbl[freq_i], 150);
      cliPrintf("%dHz, %dms\n", freq_tbl[freq_i], 100);
      delay(300);
    }
    ret = true;
  }

  if (args->argc == 1 && args->isStr(0, "melody"))
  {
    uint16_t melody[] = {NOTE_C4, NOTE_G3, NOTE_G3, NOTE_A3, NOTE_G3, 0, NOTE_B3, NOTE_C4};
    int note_durations[] = { 4, 8, 8, 4, 4, 4, 4, 4 };

    for (int i=0; i<8; i++) 
    {
      int note_duration = 1000 / note_durations[i];

      buzzerOn(melody[i], note_duration);
      delay(note_duration * 1.30);    
    }
    ret = true;
  }
  if (ret != true)
  {
    cliPrintf("buzzer on freq(32~500000) time_ms\n");
    cliPrintf("buzzer off\n");
    cliPrintf("buzzer test\n");
    cliPrintf("buzzer melody\n");
  }
}
#endif

#endif
