dong-higenis/stm32h5-kit/(commit log)

2026-01-15 하드웨어 및 readme 추가
2026-01-19 Revert "demo firmware"
    This reverts commit 02d4b7346fff6cad7c9a52c0d5b41be662a0508a.
    [button.c, buzzer.c, can.h]
2026-01-19 펌웨어 및 readme 추가
2026-01-26 예제 코드 추가 : LED, UART
2026-01-29 Readme 갱신 및 예제코드 보충
2026-01-29 예제 - CAN 추가
2026-03-04 센서 통신 예제 추가 [modbus]
2026-03-27 추가 > 보드 테스트용 코드
    [H5_KIT_Test Debug.cfg]
2026-04-01 수정 > 버전 업데이트
    [button.c, buzzer.c, can.h, custom_fram.c]
2026-04-09 테스트 추가>
2026-04-09 추가 > 브링업 : SD카드
2026-04-09 추가 > fatfs
2026-04-10 추가 > lwip
2026-04-10 추가중 > sd writer thread
2026-04-10 추가중 > writer
2026-04-13 추가중 > 스레드 테스트
2026-04-16 파일 정리
2026-04-16 수정 > 힙사이즈 증가
2026-04-16 수정 > 파일 시스템 설정
2026-04-16 진행 > 리팩토링
2026-04-21 수정 > USART10 하드웨어 초기화 버그 수정
    [uart.c]
2026-04-21 수정 > 여타 프로토콜 시스템 기획중
    [uart.c]
2026-04-22 추가> Readme, 수정 > 프로젝트명
    [button.c, buzzer.c, can.h]
2026-04-22 추가 > Readme, 수정> 프로젝트명
    [button.c, buzzer.c, can.h]
2026-04-22 수정 >Readme 오타
2026-04-23 수정 > 예외처리 추가 (사이즈 단위로 로그 파일 변경)
2026-04-24 수정 > 용량기반 -> 시간기반
    [rtc.c]
