dong-higenis/stm32h5-kit/(notices)

Notices in the files:
firmware/H5_SENSOR_READER/Core/Inc/main.h:
Copyright (c) 2026 STMicroelectronics.
All rights reserved.
This software is licensed under terms that can be found in the LICENSE file
